fedulvtubudul/warm-woody-knocker/(threads)

Thread 1 (2017-11-21):

Objective-C? Swift?

nikolakulikov, 2017-11-21:
Здравствуйте, Александр!
Сразу хочу извиниться, что пишу вам в гитхаб.
Я ищу разработчика с опытом в Objective-C (который у вас есть, судя по репозиторию :), хотя бы пониманием Swift, возможностью разговаривать хотя бы на ломаном английском и суммарным опытом в iOS от 2 до 100 лет :)
Напишите, пожалуйста, в скайп cv.kulikov@gmail.com (это именно скайп), если это про вас :)
Спасибо
