fedulvtubudul/warm-woody-knocker/(commit log)

2017-12-30 Implement a routine for handling button click and long press
2017-12-30 Use time-based debounce for button taps and holds
2017-12-30 Implement a routine for handling encoder spin events
2018-01-01 Remove Xcode-related files, switch to VSCode
2018-01-13 Fix circular toggling for rhythms
    [warm_woody_knocker.ino]
2018-01-13 Add check/resetState methods to Rhythm
    [warm_woody_knocker.ino]
2018-02-18 Add missing initial value for Enum Parameter
    [warm_woody_knocker.ino]
2018-02-18 Implement Track class to store state separately for each channel(magnet)
2019-02-16 Fix player in case of "0" meter size
2020-01-01 Refactor pulse "playing" to synchronous manner
    Fix pulse width inconsistency caused by poor run-loop performance
    [warm_woody_knocker.ino]
2020-01-18 Add schematics images
2021-05-25 Implement showing tempo in milliseconds
2021-10-08 Fix parameters list after loading with Pattern rhythm selected
    [warm_woody_knocker.ino]
